CGrassin/warbl/WARBL_PCB/WARBL2.2.kicad_pcb

## KiCad design WARBL_PCB/WARBL2.2.kicad_pcb (2020-08-31)

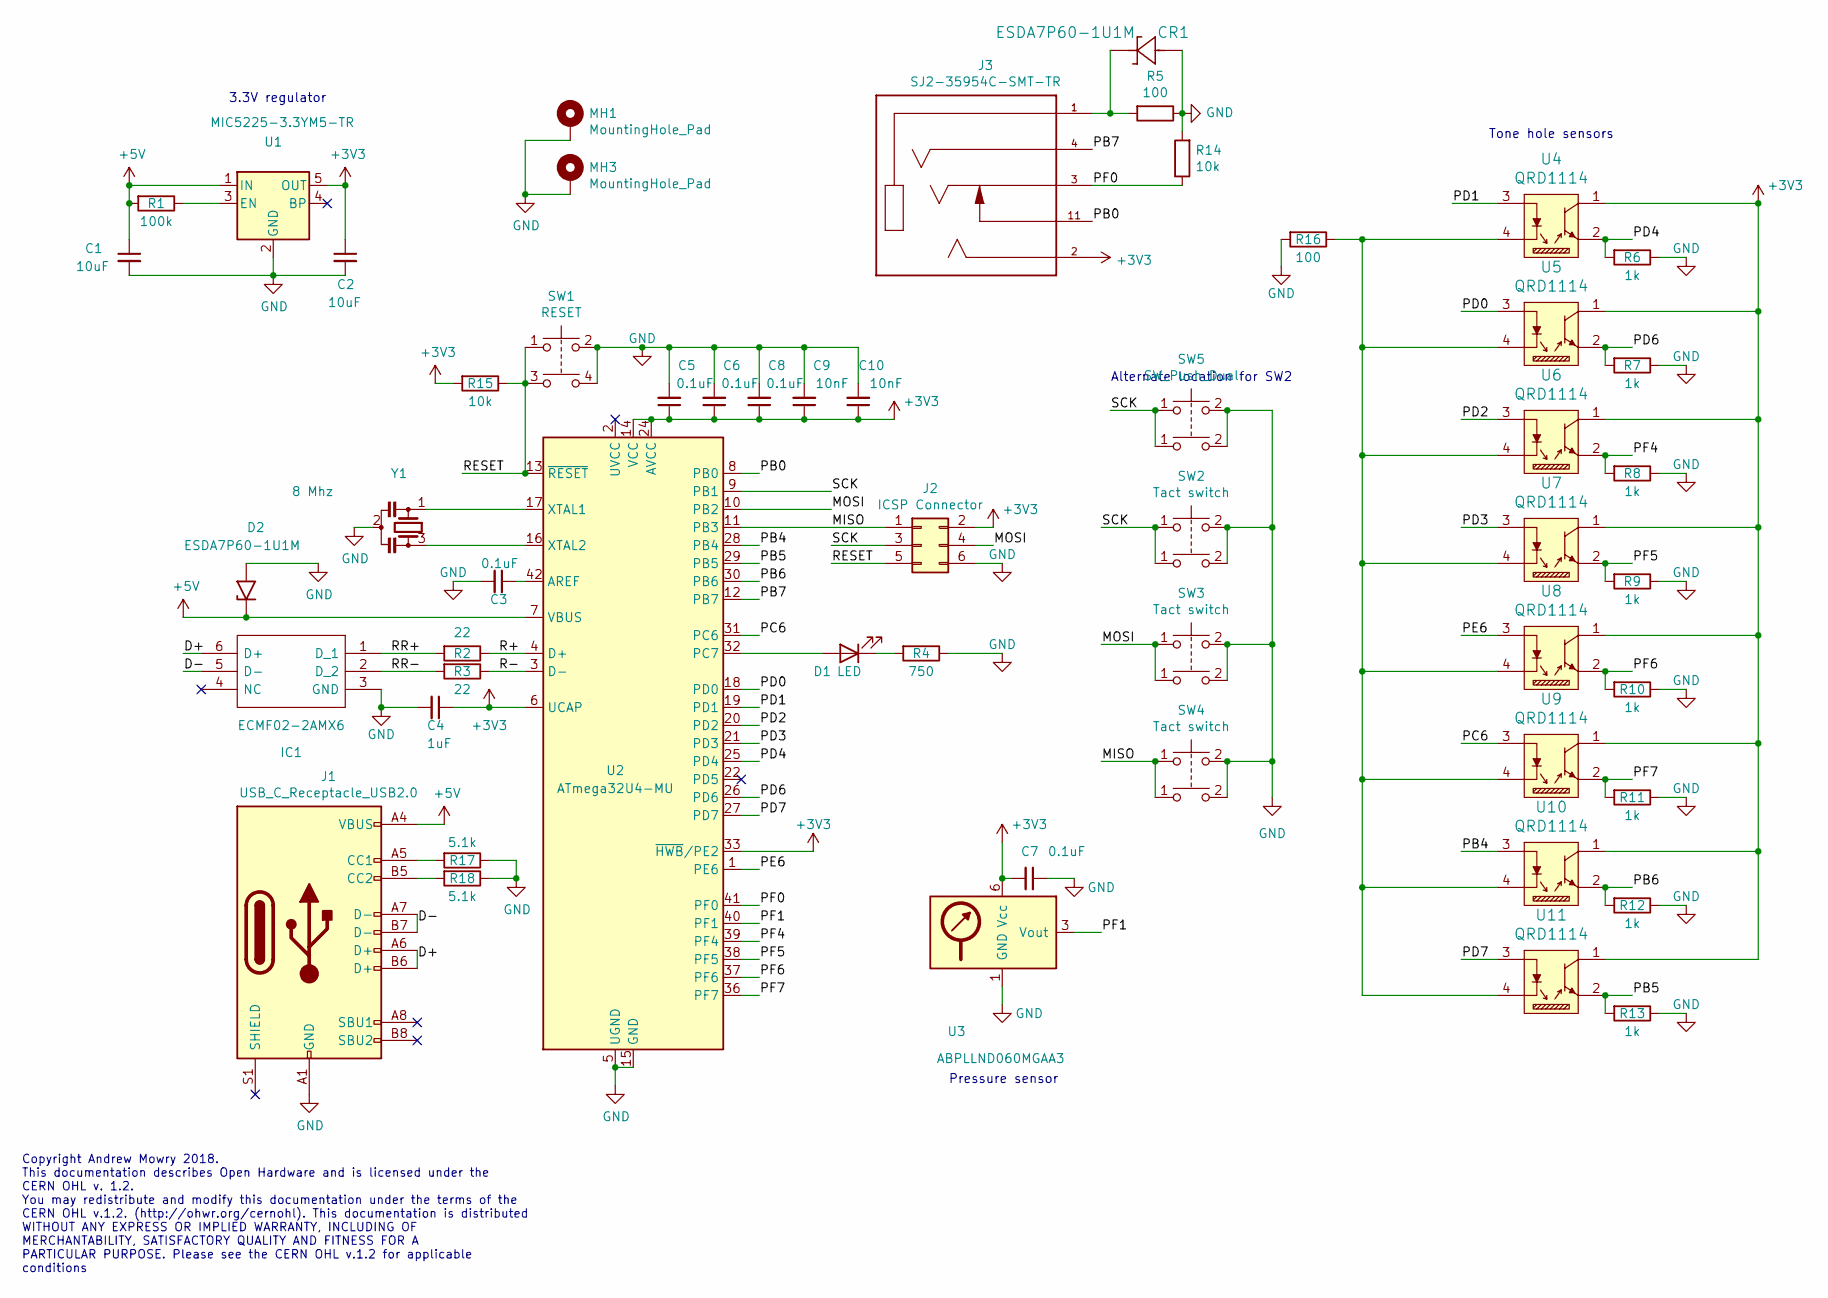
[picture p1: schematic WARBL2.2.sch, WARBL]

Parts:
C1, C2: 10uF; C_0603; Mfg Part # CL10A106KQ8NNNC
C3, C5, C6, C7, C8: 0.1uF; C_0603; Mfg Part # CL10F104ZB8NNNC; Digi-Key_PN 0.1µF -20%, +80% 50V Ceramic Capacitor 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
C4: 1uF; C_0603; Mfg Part # CL10B105KP8NNNC
C9, C10: 10nF; C_0603; Mfg Part # CL10B103KB8NCNC; Digi-Key_PN 10000pF ±10% 50V Ceramic Capacitor X7R 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
CR1: ESDA7P60-1U1M
D1: LED; LED_0603; Mfg Part # LG L29K-G2J1-24-Z
D2: ESDA7P60-1U1M; D_DO-201AE_P15.24mm_Horizontal; Mfg Part # ESDA7P60-1U1M
IC1: ECMF02-2AMX6; SON50P150X170X55-6N-D; Mfg Part # ECMF02-2AMX6
J1: USB_C_Receptacle_USB2.0; USB_C_Receptacle_HRO_TYPE-C-31-M-12
J2: ICSP Connector; PinHeader_2x03_P2.54mm_Vertical
J3: SJ2-35954C-SMT-TR; WARBL_CUI_SJ2-35954C-SMT-TR
MH1, MH3: MountingHole_Pad; MountingHole_0.089in_2_56_Pad
R1: 100k; R_0603; Mfg Part # ERJ-3EKF1003V; Digi-Key_PN 100 kOhms ±1% 0.1W, 1/10W Chip Resistor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
R2, R3: 22; R_0603_1608Metric; Mfg Part # ERJ-3EKF22R0V; Digi-Key_PN 22 Ohms ±1% 0.1W, 1/10W Chip Resistor 0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
R4: 750; R_0603; Mfg Part # ERJ-3GEYJ751V; Digi-Key_PN 750 Ohms ±5% 0.1W, 1/10W Chip Resistor 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
R5: 100; R_0603_1608Metric
R6, R7, R8, R9, R10, R11, R12, R13: 1k; R_0603; Mfg Part # ERJ-3GEYJ102V
R14: 10k; R_0603_1608Metric
R15: 10k; R_0603; Mfg Part # ERJ-3GEYJ103V
R16: 100; R_0603; Mfg Part # ERJ-3EKF1000V
R17, R18: 5.1k; R_0603_1608Metric; Mfg Part # ERJ-3GEYJ103V
SW1: RESET; SW_KMR221GLFS; Mfg Part # KMR211GLFS
SW2, SW3, SW4: Tact switch; TL3305BF160QG
SW5: SW_Push_Dual; TL3305BF160QG
U1: 3.3V; SOT-23-5; Mfg Part # MIC5225-3.3YM5-TR
U2: ATmega32U4-MU; QFN-44-1EP_7x7mm_Pitch0.5mm; Mfg Part # ATMEGA32U4-MU
U3: ABPLLND060MGAA3
U4, U5, U6, U7, U8, U9, U10, U11: QRD1114; Reflective_Sensor_QRD1114; MPN QRD1114; Digi-Key_PN QRD1114-ND
Y1: 8 Mhz; CSTNE16M0V530000R0; Mfg Part # CSTNE8M00GH5L000R0

Connections:
+3V3: C2.1, C4.1, C5.1, C6.1, C7.2, C8.1, C9.1, C10.1, J2.2, J3.2, R15.2, U1.5 (OUT), U2.6 (UCAP), U2.14 (VCC), U2.24 (AVCC), U2.33 (~HWB~/PE2), U2.34 (VCC), U2.44 (AVCC), U3.6 (Vcc), U4.1, U5.1, U6.1, U7.1, U8.1, U9.1, U10.1, U11.1
+5V: C1.1, D2.1 (A1), J1.A4 (VBUS), J1.A9 (VBUS), J1.B4 (VBUS), J1.B9 (VBUS), R1.2, U1.1 (IN), U2.7 (VBUS)
/D+: IC1.6 (D+), J1.A6 (D+), J1.B6 (D+)
/D-: IC1.5 (D-), J1.A7 (D-), J1.B7 (D-)
/MISO: J2.1, SW4.1, U2.11 (PB3)
/MOSI: J2.4, SW3.1, U2.10 (PB2)
/PB0: J3.11, U2.8 (PB0)
/PB4: U2.28 (PB4), U10.3
/PB5: R13.2, U2.29 (PB5), U11.2
/PB6: R12.2, U2.30 (PB6), U10.2
/PB7: J3.4, U2.12 (PB7)
/PC6: U2.31 (PC6), U9.3
/PD0: U2.18 (PD0), U5.3
/PD1: U2.19 (PD1), U4.3
/PD2: U2.20 (PD2), U6.3
/PD3: U2.21 (PD3), U7.3
/PD4: R6.2, U2.25 (PD4), U4.2
/PD6: R7.2, U2.26 (PD6), U5.2
/PD7: U2.27 (PD7), U11.3
/PE6: U2.1 (PE6), U8.3
/PF0: J3.3, R14.1, U2.41 (PF0)
/PF1: U2.40 (PF1), U3.3 (Vout)
/PF4: R8.2, U2.39 (PF4), U6.2
/PF5: R9.2, U2.38 (PF5), U7.2
/PF6: R10.2, U2.37 (PF6), U8.2
/PF7: R11.2, U2.36 (PF7), U9.2
/R+: R2.1, U2.4 (D+)
/R-: R3.1, U2.3 (D-)
/RESET: J2.5, R15.1, SW1.1, SW1.3, U2.13 (~RESET)
/RR+: IC1.1 (D_1), R2.2
/RR-: IC1.2 (D_2), R3.2
/SCK: J2.3, SW2.1, SW5.1, U2.9 (PB1)
GND: C1.2, C2.2, C3.2, C4.2, C5.2, C6.2, C7.1, C8.2, C9.2, C10.2, CR1.2, D2.2 (A2), IC1.3 (GND), J1.A1 (GND), J1.A12 (GND), J1.B1 (GND), J1.B12 (GND), J2.6, MH1.1, MH3.1, R4.1, R5.1, R6.1, R7.1, R8.1, R9.1, R10.1, R11.1, R12.1, R13.1, R14.2, R16.2, R17.1, R18.1, SW1.2, SW1.4, SW2.2, SW3.2, SW3.4, SW4.2, SW5.2, U1.2 (GND), U2.5 (UGND), U2.15 (GND), U2.23 (GND), U2.35 (GND), U2.43 (GND), U2.45 (GND), U3.1 (GND), Y1.2
unnamed: C3.1, U2.42 (AREF)
unnamed: CR1.1, J3.1, R5.2
unnamed: D1.1 (K), R4.2
unnamed: D1.2 (A), U2.32 (PC7)
unnamed: J1.A5 (CC1), R17.2
unnamed: J1.B5 (CC2), R18.2
unnamed: R1.1, U1.3 (EN)
unnamed: R16.1, U4.4, U5.4, U6.4, U7.4, U8.4, U9.4, U10.4, U11.4
unnamed: U2.16 (XTAL2), Y1.3
unnamed: U2.17 (XTAL1), Y1.1

Notes on the sheet:
Tone hole sensors
3.3V regulator
Pressure sensor
Copyright Andrew Mowry 2018. This documentation describes Open Hardware and is licensed under the CERN OHL v. 1.2. You may redistribute and modify this documentation under the terms of the CERN OHL v.1.2. (http://ohwr.org/cernohl). This documentation is distributed WITHOUT ANY EXPRESS OR IMPLIED WA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
Alternate location for SW2

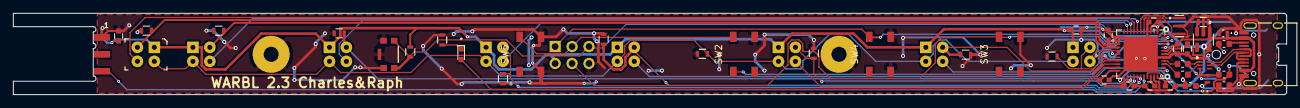
[picture p2: board WARBL2.2.kicad_pcb from above]

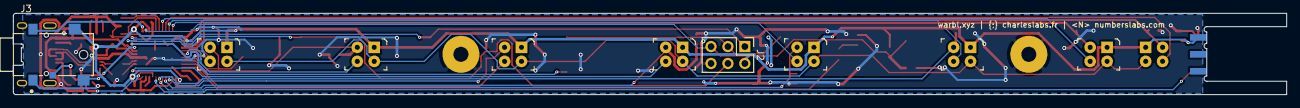
[picture p3: board WARBL2.2.kicad_pcb from below]

Board: 4 copper layers, 191.2 x 12.2 mm, 54 parts (9 on the bottom side), 43 nets.
