CGrassin/warbl/(commit log)

2020-08-20 Added original PCB files
    [WARBL2.2.kicad_pcb, WARBL2.2.sch]
2020-08-20 Prepared PCB for 2 layers routing
    [WARBL2.2.kicad_pcb]
2020-08-25 First routing try, USB side of PCB done
    [WARBL2.2.kicad_pcb, WARBL2.2.sch]
2020-08-25 Changed footprints, added again jack connector, no routing
    [WARBL2.2.kicad_pcb, WARBL2.2.sch]
2020-08-25 Routed jack connector and all its components, modified board outlines to accomodate
    [WARBL2.2.kicad_pcb, WARBL2.2.sch]
2020-08-26 Routed front and lower pins of the uC
    [WARBL2.2.kicad_pcb, WARBL2.2.sch]
2020-08-26 Routed everything but ground
    [WARBL2.2.kicad_pcb]
2020-08-26 Finished board routing
    [WARBL2.2.kicad_pcb]
2020-08-27 Cleaned silkscreen and added Gerbers
    [WARBL2.2-B_Mask.gbs, WARBL2.2-B_SilkS.gbo, WARBL2.2-Back.gbl, WARBL2.2-Edge_Cuts.gm1, WARBL2.2-F_Mask.gts, WARBL2.2-F_SilkS.gto, WARBL2.2-Front.gtl, WARBL2.2-NPTH.drl]
2020-08-27 Deleted no-copper zones that were present on original design and re-generated gerbers/zip
    [WARBL2.2-B_Mask.gbs, WARBL2.2-B_SilkS.gbo, WARBL2.2-Back.gbl, WARBL2.2-Edge_Cuts.gm1, WARBL2.2-F_Mask.gts, WARBL2.2-F_SilkS.gto, WARBL2.2-Front.gtl, WARBL2.2-NPTH.drl]
2020-08-29 Better ground loops, better thermal relief for USB-C, improved some tracks routing
    [WARBL2.2-B_Mask.gbs, WARBL2.2-B_SilkS.gbo, WARBL2.2-Back.gbl, WARBL2.2-Edge_Cuts.gm1, WARBL2.2-F_Mask.gts, WARBL2.2-F_SilkS.gto, WARBL2.2-Front.gtl, WARBL2.2-NPTH.drl]
2020-08-31 Resistor was behind a button
    [WARBL2.2-B_Mask.gbs, WARBL2.2-B_SilkS.gbo, WARBL2.2-Back.gbl, WARBL2.2-Edge_Cuts.gm1, WARBL2.2-F_Mask.gts, WARBL2.2-F_SilkS.gto, WARBL2.2-Front.gtl, WARBL2.2-NPTH.drl]
2020-08-31 Added interractive BOM file
